Skrywerbeer/AquariumDaglig/daglig.brd

## EAGLE design daglig.brd (2021-10-26)

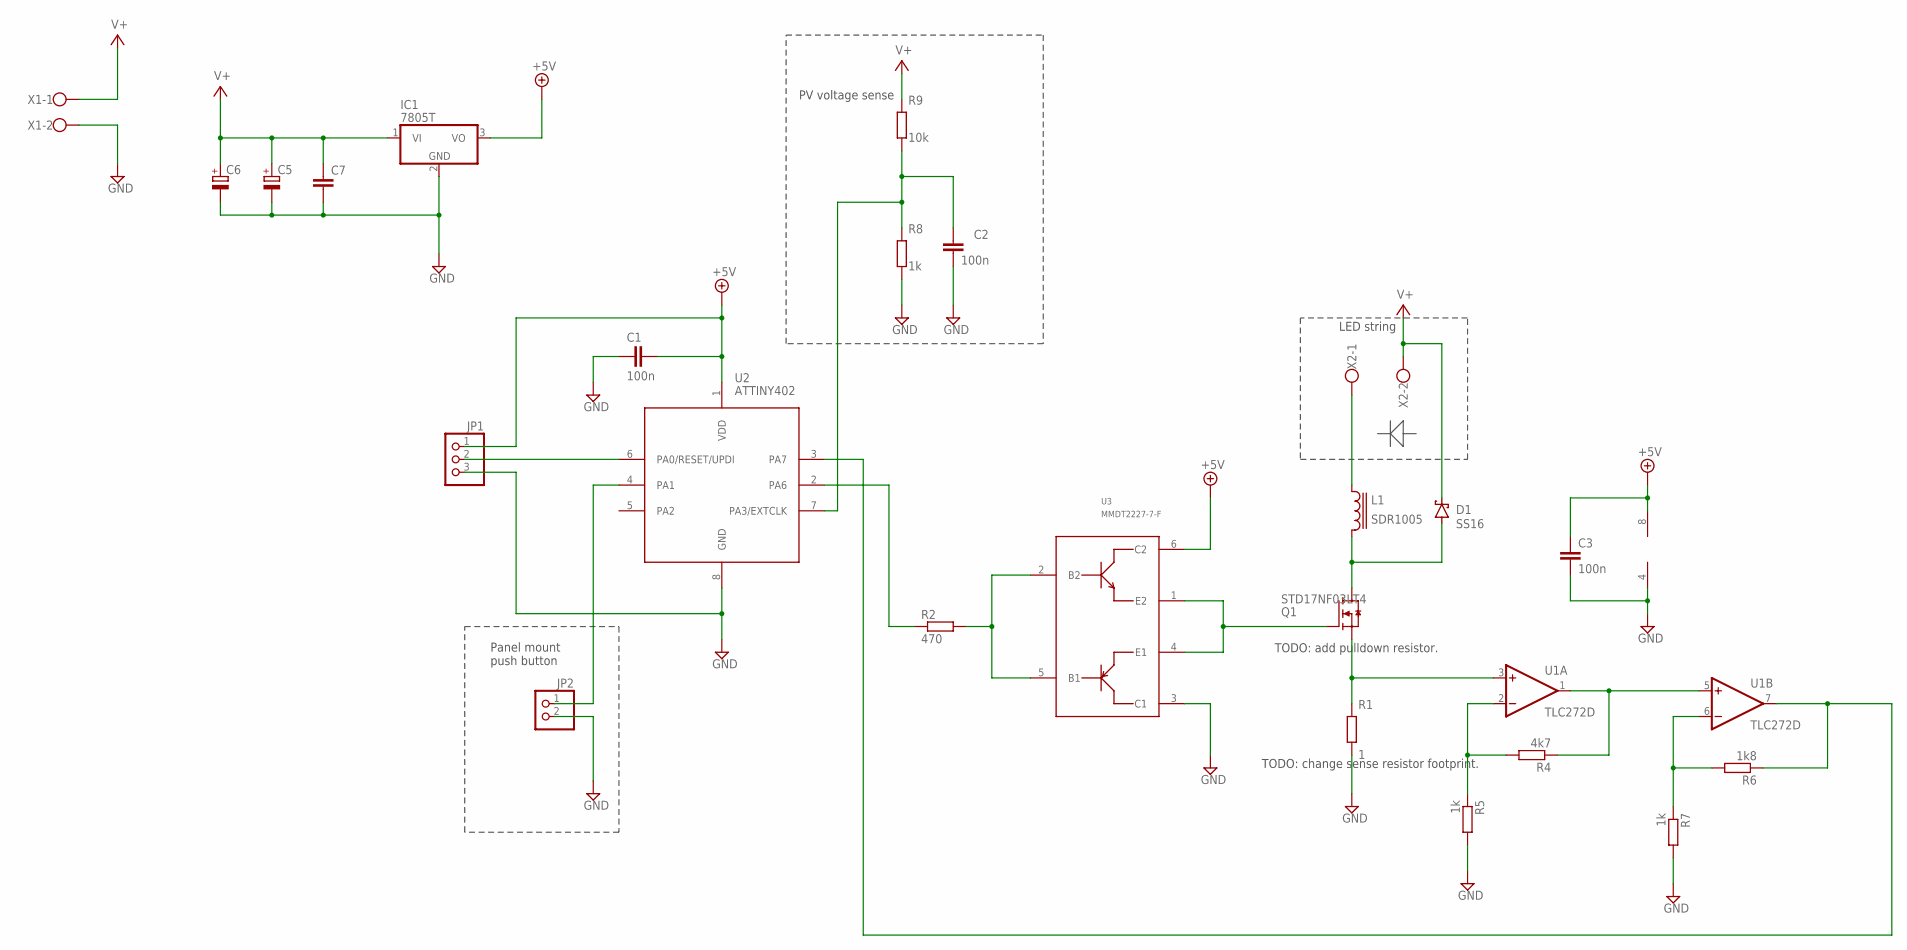
[picture p1: schematic daglig.sch]

Parts:
C1, C2, C3: 100n; C0805
C5, C6: CPOL-EUE5-10.5; E5-10,5
C7: C-EUC0805; C0805
D1: SS16; DO214AC
IC1: 7805T; TO220H
JP1: PINHD-1X3; 1X03
JP2: PINHD-1X2; 1X02
L1: SDR1005
Q1: STD17NF03LT4; TO252
R1: 1; R2512
R2: 470; R0805
R4: 4k7; R0805
R5, R7, R8: 1k; R0805
R6: 1k8; R0805
R9: 10k; R0805
U1: TLC272D; SO08
U2: ATTINY402; SO8
U3: MMDT2227-7-F; SOT363_PHILIPS
X1, X2: W237-102

Connections:
+5V: C1.2, C3.1, IC1.3 (VO), JP1.1, U1.8 (V+), U2.1 (VDD), U3.6 (C2)
GND: C1.1, C2.2, C3.2, C5.-, C6.-, C7.2, IC1.2 (GND), JP1.3, JP2.2, R1.1, R5.2, R7.2, R8.1, U1.4 (V-), U2.8 (GND), U3.3 (C1), X1.2
unnamed: Q1.1 (G), U3.1 (E2), U3.4 (E1)
unnamed: D1.A, L1.2, Q1.3 (D)
unnamed: R2.2, U3.2 (B2), U3.5 (B1)
unnamed: R2.1, U2.2 (PA6)
unnamed: Q1.2 (S), R1.2, U1.3 (+IN)
unnamed: R4.1, U1.1 (OUT), U1.5 (+IN)
unnamed: R6.1, U1.7 (OUT), U2.3 (PA7)
unnamed: R6.2, R7.1, U1.6 (-IN)
unnamed: R4.2, R5.1, U1.2 (-IN)
unnamed: L1.1, X2.1
unnamed: JP1.2, U2.6 (PA0/RESET/UPDI)
unnamed: C2.1, R8.2, R9.1, U2.7 (PA3/EXTCLK)
unnamed: JP2.1, U2.4 (PA1)
V+: C5.+, C6.+, C7.1, D1.C, IC1.1 (VI), R9.2, X1.1, X2.2

Notes on the sheet:
LED string
PV voltage sense
Panel mount push button
TODO: add pulldown resistor.
TODO: change sense resistor footprint.

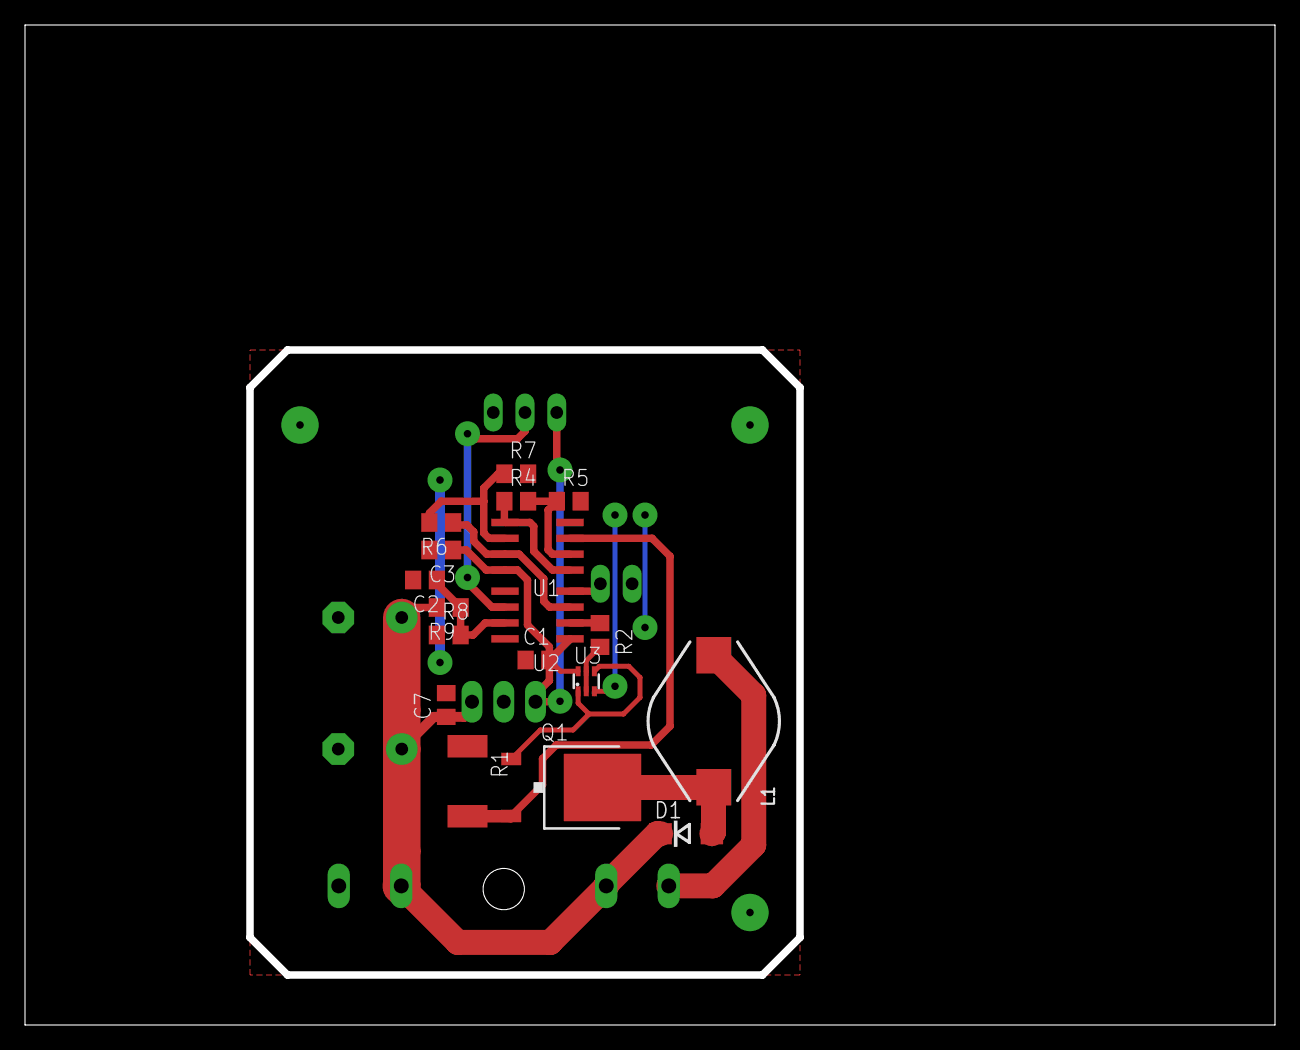
[picture p2: board daglig.brd from above]

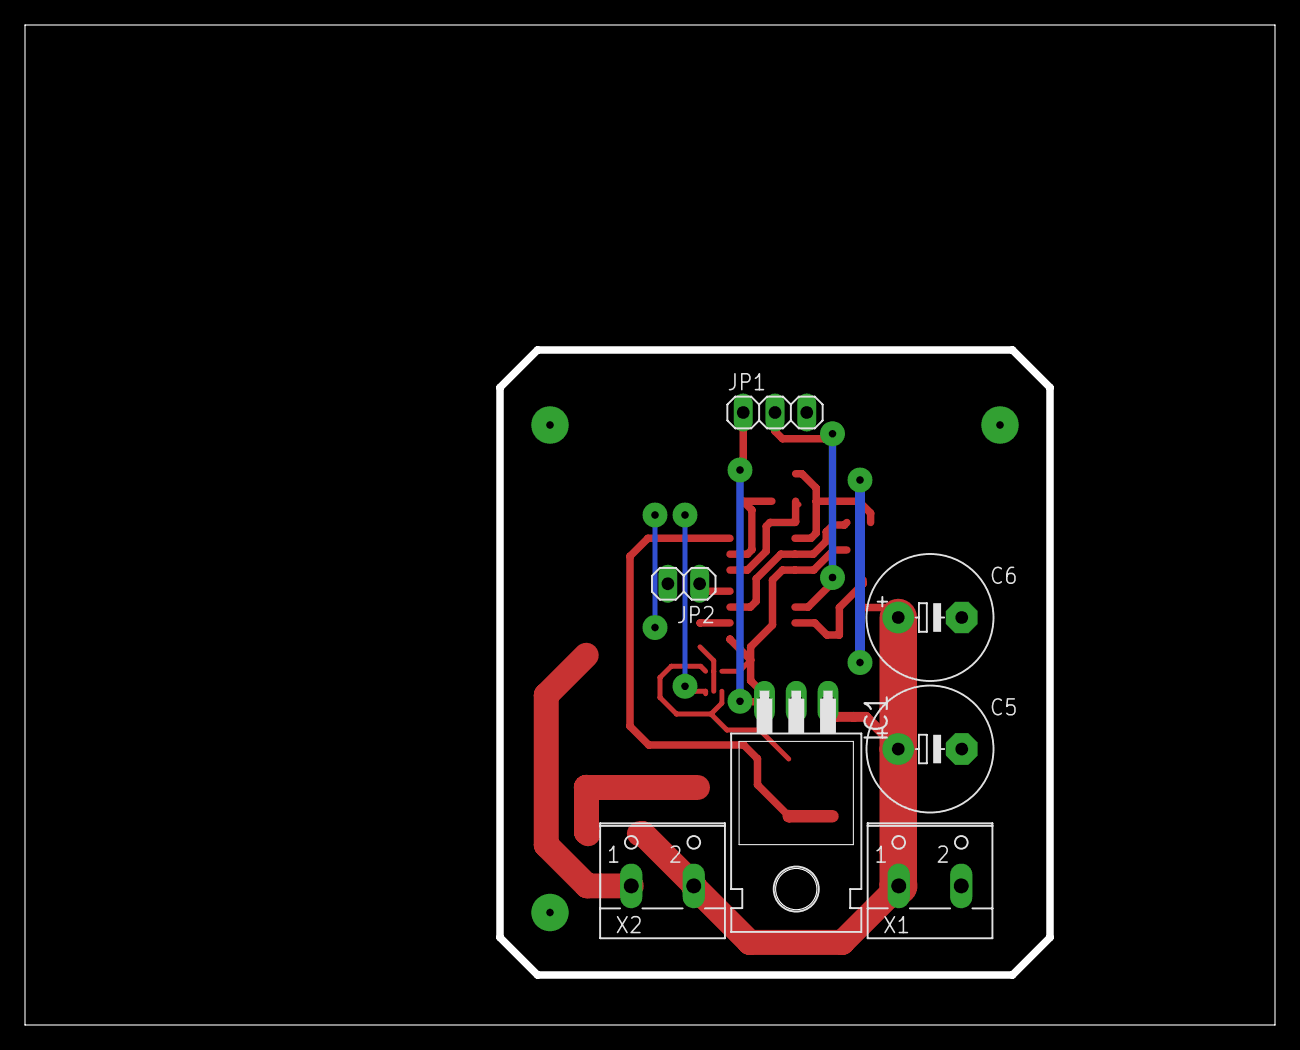
[picture p3: board daglig.brd from below]

Board: 2 copper layers, 100.0 x 80.0 mm, 25 parts (7 on the bottom side), 16 nets.
