Skrywerbeer/AquariumDaglig/(commit log)

2021-10-21 Initial commit. Rev2.
    [daglig.brd, daglig.sch]
2021-10-25 Increased accumulated samples to sixteen.
2021-10-26 Added images of the boards layout and dimensions.
2021-10-26 Added todos and resistor values.
    [daglig.brd, daglig.sch]
