Skrywerbeer/AquariumDaglig/(notices)

Notices in the files:
parts and their libraries:
inductor-bourns: Copyright (C) 2008, Bob Starr
